DeanKuruzovich/UAV-Thrust-Stand/teststand.kicad_sch

## KiCad design teststand.kicad_sch (2026-09-09)

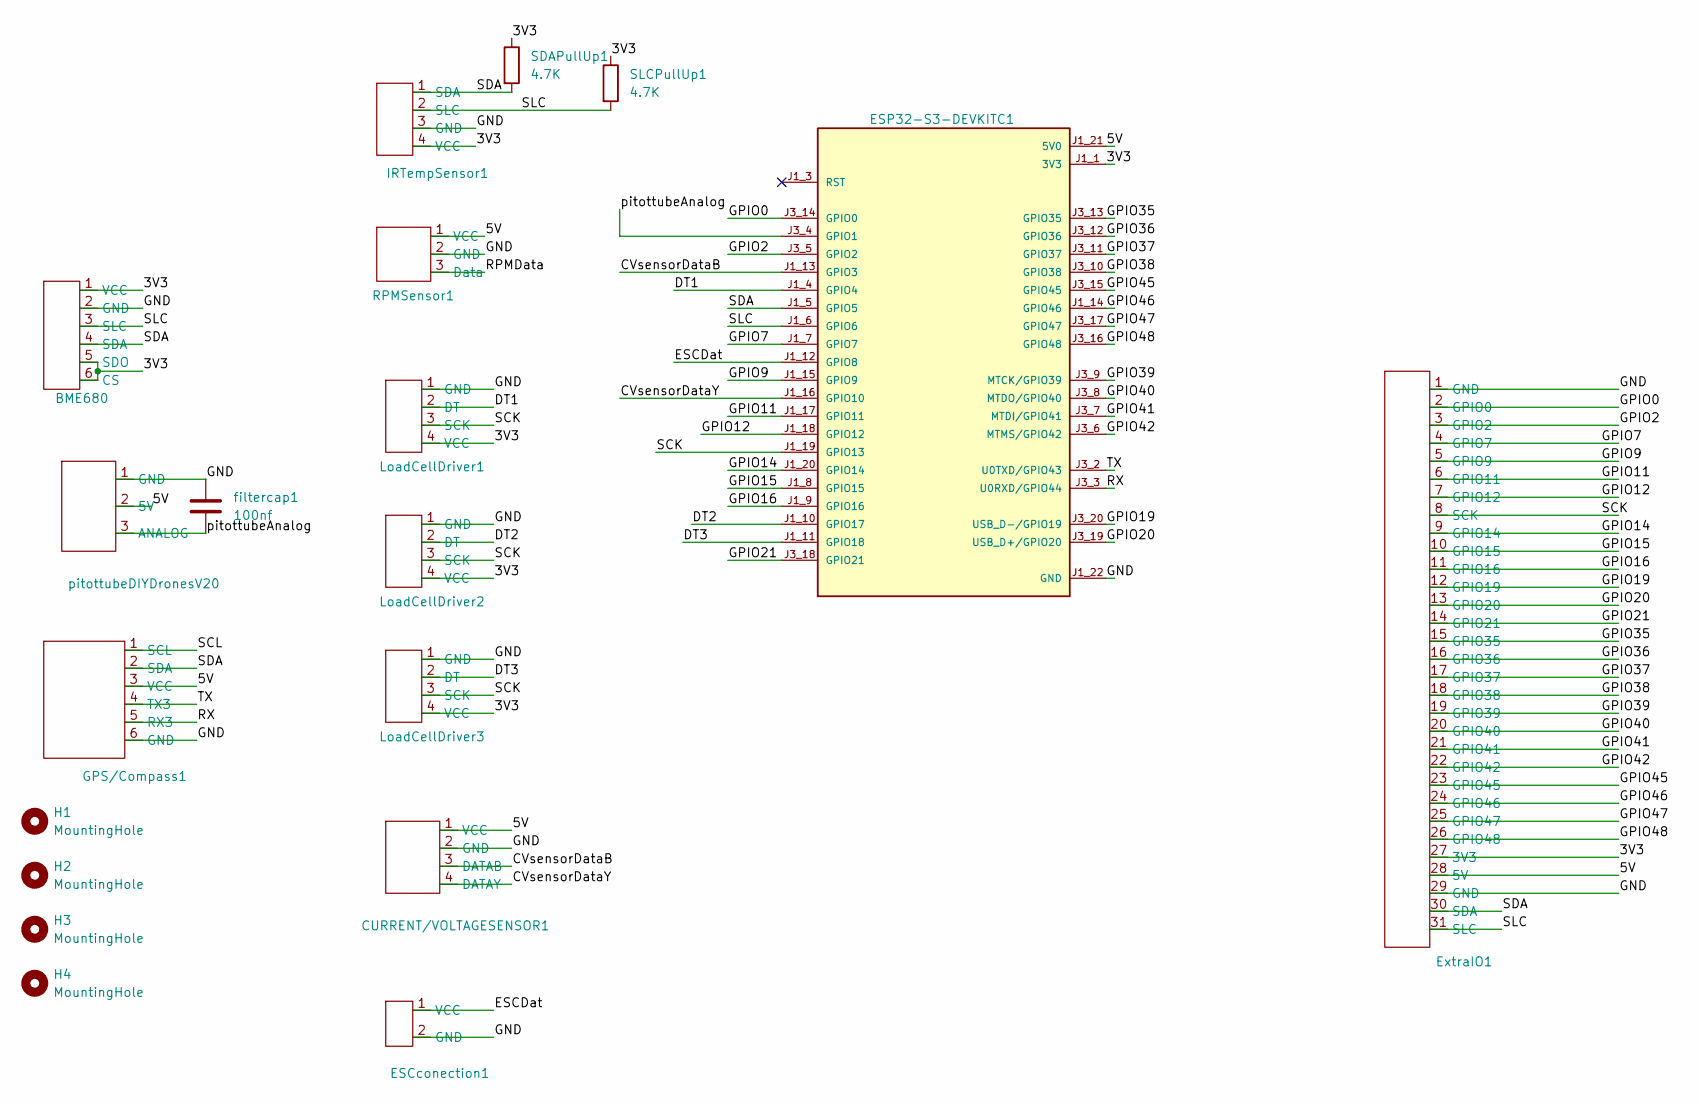
[picture p1: schematic teststand.kicad_sch]

Parts:
BME680: PinHeader_1x06_P2.54mm_Vertical
CURRENT/VOLTAGESENSOR1: PinHeader_1x04_P2.54mm_Vertical
ESCconection1: PinHeader_1x02_P2.54mm_Vertical
ESP32-S3-DEVKITC1: ESP32-S3-DEVKITC-1-N8R2; XCVR_ESP32-S3-DEVKITC-1-N8R2; PARTREV V1
ExtraIO1: PinHeader_1x30_P2.00mm_Horizontal
GPS/Compass1: PinHeader_1x06_P2.54mm_Vertical
H1, H2, H3, H4: MountingHole; MountingHole_3.2mm_M3
IRTempSensor1: PinHeader_1x04_P2.54mm_Vertical
LoadCellDriver1, LoadCellDriver2, LoadCellDriver3: PinHeader_1x04_P2.54mm_Vertical
RPMSensor1: PinHeader_1x03_P2.54mm_Vertical
SDAPullUp1: 4.7K; R_LDR_5.2x5.2mm_P3.5mm_Horizontal
SLCPullUp1: 4.7K; R_LDR_5.2x5.2mm_P3.5mm_Horizontal
filtercap1: 100nf; C_Axial_L3.8mm_D2.6mm_P7.50mm_Horizontal
pitottubeDIYDronesV20: PinHeader_1x03_P2.54mm_Vertical

Connections:
3V3: BME680.1 (VCC), BME680.5 (SDO), BME680.6 (CS), ESP32-S3-DEVKITC1.J1_1 (3V3), ESP32-S3-DEVKITC1.J1_2 (3V3), ExtraIO1.27 (3V3), IRTempSensor1.4 (VCC), LoadCellDriver1.4 (VCC), LoadCellDriver2.4 (VCC), LoadCellDriver3.4 (VCC), SDAPullUp1.1, SLCPullUp1.1
5V: CURRENT/VOLTAGESENSOR1.1 (VCC), ESP32-S3-DEVKITC1.J1_21 (5V0), ExtraIO1.28 (5V), GPS/Compass1.3 (VCC), RPMSensor1.1 (VCC), pitottubeDIYDronesV20.2 (5V)
CVsensorDataB: CURRENT/VOLTAGESENSOR1.3 (DATAB), ESP32-S3-DEVKITC1.J1_13 (GPIO3)
CVsensorDataY: CURRENT/VOLTAGESENSOR1.4 (DATAY), ESP32-S3-DEVKITC1.J1_16 (GPIO10)
DT1: ESP32-S3-DEVKITC1.J1_4 (GPIO4), LoadCellDriver1.2 (DT)
DT2: ESP32-S3-DEVKITC1.J1_10 (GPIO17), LoadCellDriver2.2 (DT)
DT3: ESP32-S3-DEVKITC1.J1_11 (GPIO18), LoadCellDriver3.2 (DT)
ESCDat: ESCconection1.1 (VCC), ESP32-S3-DEVKITC1.J1_12 (GPIO8)
GND: BME680.2 (GND), CURRENT/VOLTAGESENSOR1.2 (GND), ESCconection1.2 (GND), ESP32-S3-DEVKITC1.J1_22 (GND), ESP32-S3-DEVKITC1.J3_1 (GND), ESP32-S3-DEVKITC1.J3_21 (GND), ESP32-S3-DEVKITC1.J3_22 (GND), ExtraIO1.1 (GND), ExtraIO1.29 (GND), GPS/Compass1.6 (GND), IRTempSensor1.3 (GND), LoadCellDriver1.1 (GND), LoadCellDriver2.1 (GND), LoadCellDriver3.1 (GND), RPMSensor1.2 (GND), filtercap1.1, pitottubeDIYDronesV20.1 (GND)
GPIO0: ESP32-S3-DEVKITC1.J3_14 (GPIO0), ExtraIO1.2 (GPIO0)
GPIO2: ESP32-S3-DEVKITC1.J3_5 (GPIO2), ExtraIO1.3 (GPIO2)
GPIO7: ESP32-S3-DEVKITC1.J1_7 (GPIO7), ExtraIO1.4 (GPIO7)
GPIO9: ESP32-S3-DEVKITC1.J1_15 (GPIO9), ExtraIO1.5 (GPIO9)
GPIO11: ESP32-S3-DEVKITC1.J1_17 (GPIO11), ExtraIO1.6 (GPIO11)
GPIO12: ESP32-S3-DEVKITC1.J1_18 (GPIO12), ExtraIO1.7 (GPIO12)
GPIO14: ESP32-S3-DEVKITC1.J1_20 (GPIO14), ExtraIO1.9 (GPIO14)
GPIO15: ESP32-S3-DEVKITC1.J1_8 (GPIO15), ExtraIO1.10 (GPIO15)
GPIO16: ESP32-S3-DEVKITC1.J1_9 (GPIO16), ExtraIO1.11 (GPIO16)
GPIO19: ESP32-S3-DEVKITC1.J3_20 (USB_D-/GPIO19), ExtraIO1.12 (GPIO19)
GPIO20: ESP32-S3-DEVKITC1.J3_19 (USB_D+/GPIO20), ExtraIO1.13 (GPIO20)
GPIO21: ESP32-S3-DEVKITC1.J3_18 (GPIO21), ExtraIO1.14 (GPIO21)
GPIO35: ESP32-S3-DEVKITC1.J3_13 (GPIO35), ExtraIO1.15 (GPIO35)
GPIO36: ESP32-S3-DEVKITC1.J3_12 (GPIO36), ExtraIO1.16 (GPIO36)
GPIO37: ESP32-S3-DEVKITC1.J3_11 (GPIO37), ExtraIO1.17 (GPIO37)
GPIO38: ESP32-S3-DEVKITC1.J3_10 (GPIO38), ExtraIO1.18 (GPIO38)
GPIO39: ESP32-S3-DEVKITC1.J3_9 (MTCK/GPIO39), ExtraIO1.19 (GPIO39)
GPIO40: ESP32-S3-DEVKITC1.J3_8 (MTDO/GPIO40), ExtraIO1.20 (GPIO40)
GPIO41: ESP32-S3-DEVKITC1.J3_7 (MTDI/GPIO41), ExtraIO1.21 (GPIO41)
GPIO42: ESP32-S3-DEVKITC1.J3_6 (MTMS/GPIO42), ExtraIO1.22 (GPIO42)
GPIO45: ESP32-S3-DEVKITC1.J3_15 (GPIO45), ExtraIO1.23 (GPIO45)
GPIO46: ESP32-S3-DEVKITC1.J1_14 (GPIO46), ExtraIO1.24 (GPIO46)
GPIO47: ESP32-S3-DEVKITC1.J3_17 (GPIO47), ExtraIO1.25 (GPIO47)
GPIO48: ESP32-S3-DEVKITC1.J3_16 (GPIO48), ExtraIO1.26 (GPIO48)
RPMData: RPMSensor1.3 (Data)
RX: ESP32-S3-DEVKITC1.J3_3 (U0RXD/GPIO44), GPS/Compass1.5 (RX3)
SCK: ESP32-S3-DEVKITC1.J1_19 (GPIO13), ExtraIO1.8 (SCK), LoadCellDriver1.3 (SCK), LoadCellDriver2.3 (SCK), LoadCellDriver3.3 (SCK)
SCL: GPS/Compass1.1 (SCL)
SDA: BME680.4 (SDA), ESP32-S3-DEVKITC1.J1_5 (GPIO5), ExtraIO1.30 (SDA), GPS/Compass1.2 (SDA), IRTempSensor1.1 (SDA), SDAPullUp1.2
SLC: BME680.3 (SLC), ESP32-S3-DEVKITC1.J1_6 (GPIO6), ExtraIO1.31 (SLC), IRTempSensor1.2 (SLC), SLCPullUp1.2
TX: ESP32-S3-DEVKITC1.J3_2 (U0TXD/GPIO43), GPS/Compass1.4 (TX3)
pitottubeAnalog: ESP32-S3-DEVKITC1.J3_4 (GPIO1), filtercap1.2, pitottubeDIYDronesV20.3 (ANALOG)
